ksgat/combat-robot/README.md

# combat-robot
---
title: Hitsink

author: @masoa/mas0a & @gabe/ksgat

description: We are building a fully custom antweight combat robot

created_at: "2025-05-01"
---
Demo vid: 

https://youtube.com/shorts/dfMprFvynx0



combat coming soon trust

bored side quest for two stem scholars

Why?  Ksgat and I belong to an frc team but don't get enough hands on with all aspects of the robot.  We decided to take matters into our own hands and design, build, and compete our own robot.  We went with antweight combat robotics because it has a lower barrier to entry and is an easy beginner competition.  So far, around 8 hours have been put into CAD, and we project assembly to take 10 hours.

BOM

LiperiAir 850 Mah 3s lipo	2	29.98

Bambu tpu for ams black	1	38.99

bambu petg red	1	19.99

rs 2205 2300kv motor	1	12.96

hobbywing skywalker 20amp	1	9.9

30A ESC Brushed Electronic Speed 
Controller	2	19.98

5PCS Mini N20 Gear Motor DC 3V-6V	1	8.99

uxcell M5 x 50mm 12.9 Alloy Steel Hex Socket Head Cap Screw Bolt Black 20pcs	1	9.99

100PCS M5 Locknuts Metric Nylon Inserted Hex Lock Nuts	1	5.99

Tamiya Mini Power Switch (2pk)	1	2.45

Pocket Radio Controller (M2)	1	64.99

Radiomaster ER4 reciever	1	14.99

Sales tax/shipping	$40
[ASSEMBLY GUIDE](https://github.com/ksgat/combat-robot/blob/main/build%20guide/Combat%20Bot%20Assembly.pdf)
