ksgat/combat-robot/V2/Main.stl

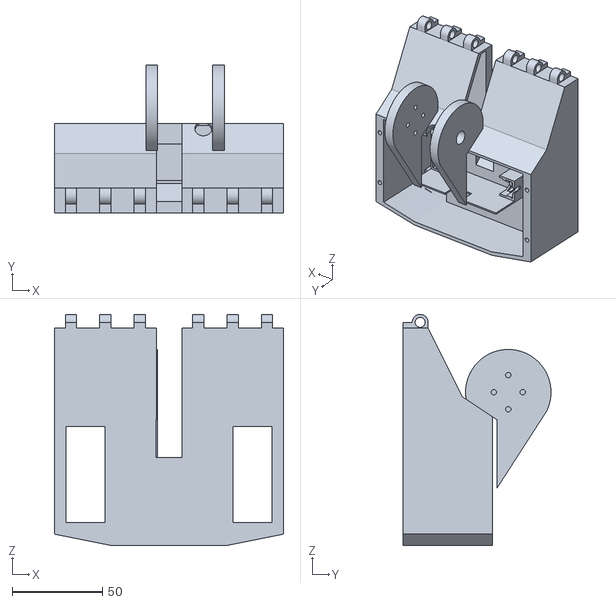
[picture p1: CAD file, 2025-05-15]
V2/Main.stl
127.0 x 82.1 x 128.3
