ksgat/combat-robot/wheel/Vheel.stl

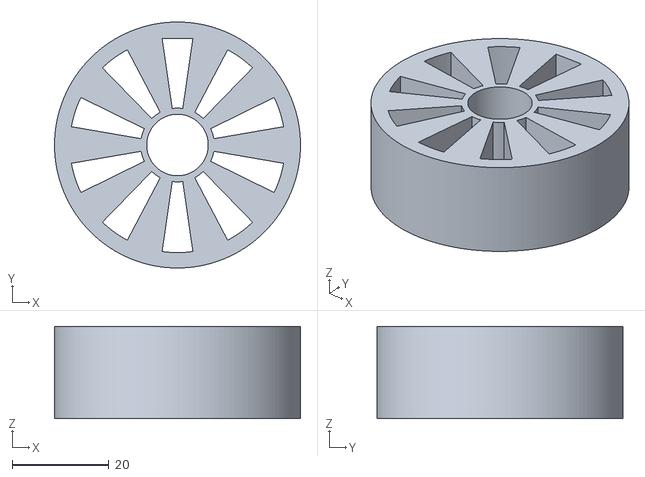
[picture p2: CAD file, 2025-05-22]
wheel/Vheel.stl
50.8 x 50.8 x 19.1
