ksgat/combat-robot/V2/Absorber.stl

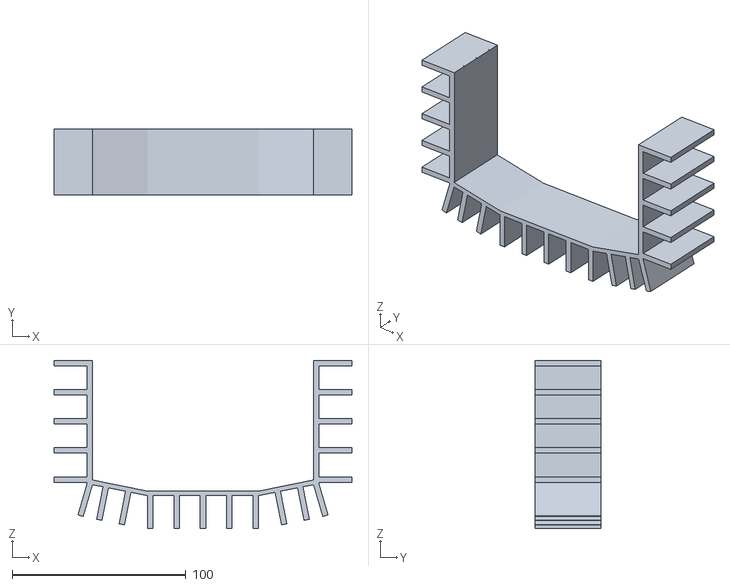
[picture p3: CAD file, 2025-05-15]
V2/Absorber.stl
171.5 x 38.1 x 96.9
