ksgat/combat-robot/wheel/Wheel Hub.stl

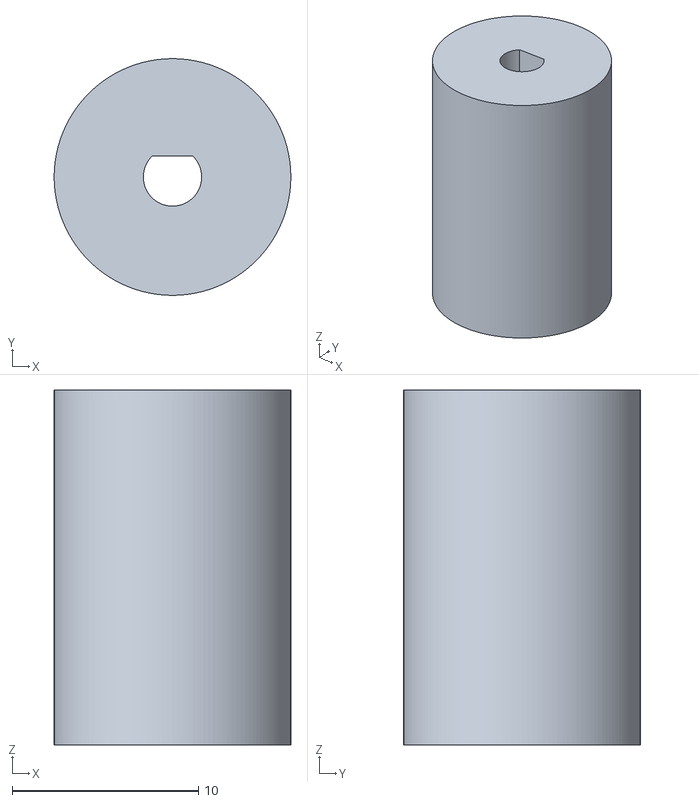
[picture p4: CAD file, 2025-05-22]
wheel/Wheel Hub.stl
12.7 x 12.7 x 19.1
