ksgat/combat-robot/V2/Wedge.stl

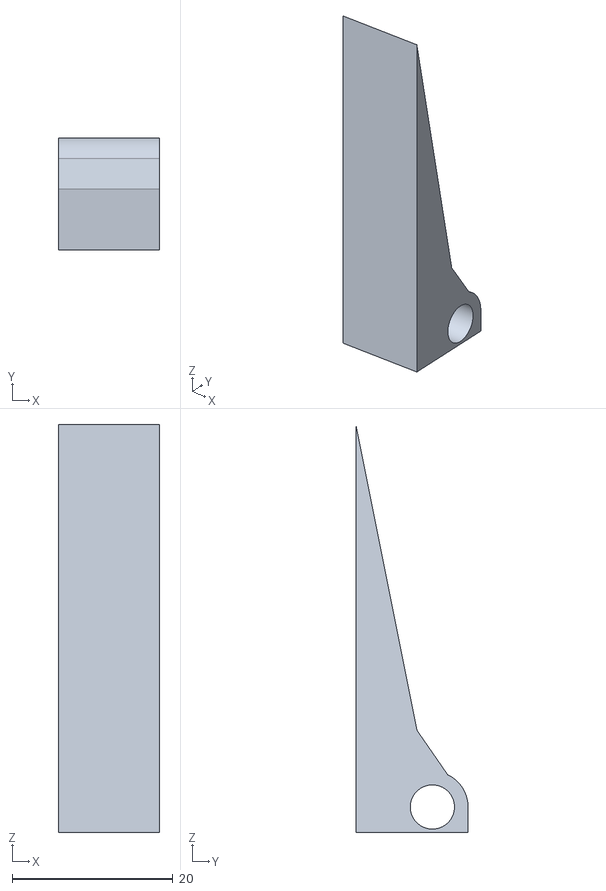
[picture p5: CAD file, 2025-05-15]
V2/Wedge.stl
12.6 x 14.0 x 50.8
