ksgat/combat-robot/V2/Divider.stl

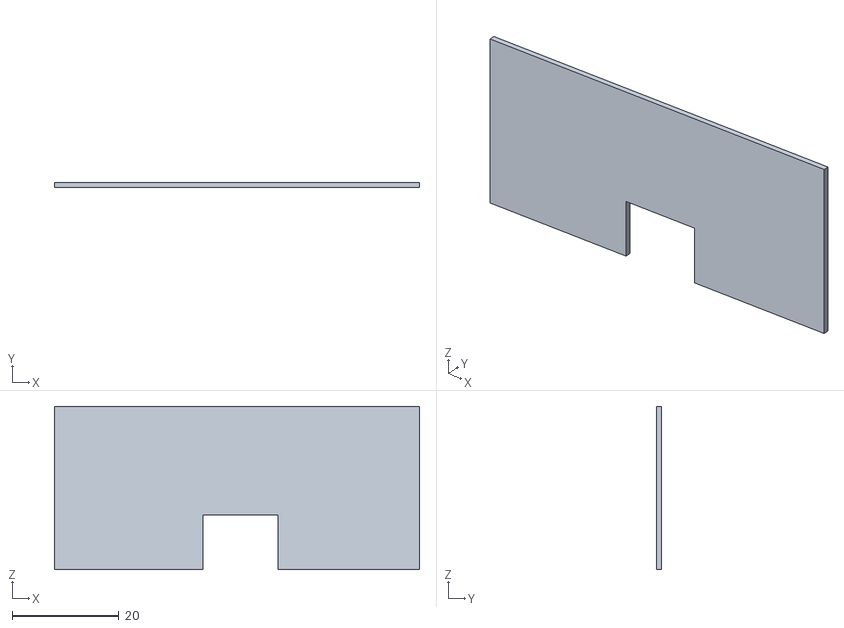
[picture p6: CAD file, 2025-05-15]
V2/Divider.stl
68.2 x 1.00 x 30.5
