ksgat/combat-robot/V2/Lid.stl

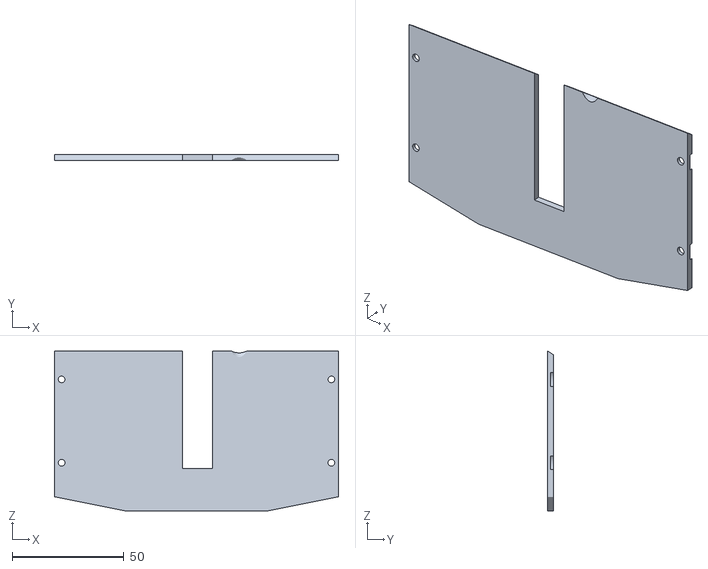
[picture p7: CAD file, 2025-05-15]
V2/Lid.stl
127.0 x 2.54 x 71.5
