ksgat/combat-robot/V2/Blade.stl

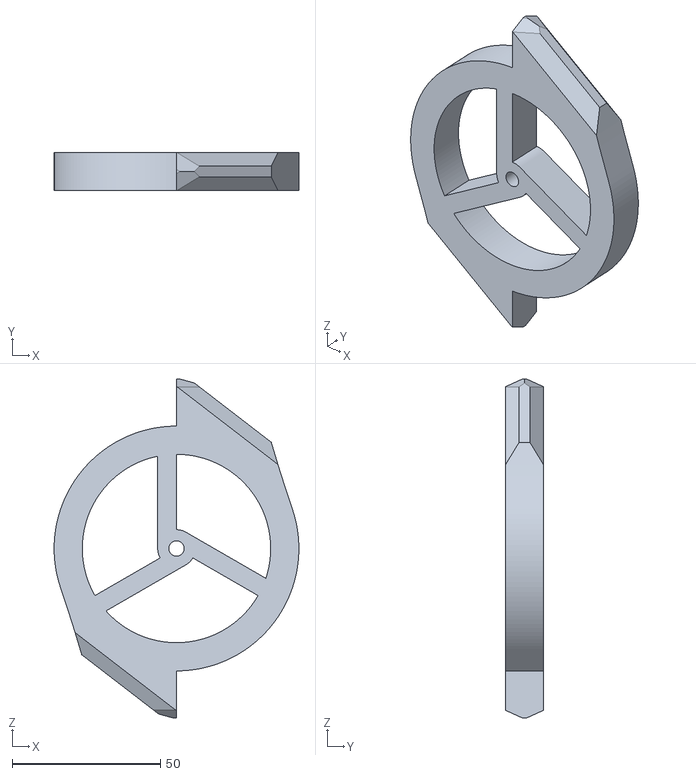
[picture p8: CAD file, 2025-05-15]
V2/Blade.stl
82.5 x 12.7 x 114.3
