ksgat/combat-robot/V1/V1bottomchasis.stl

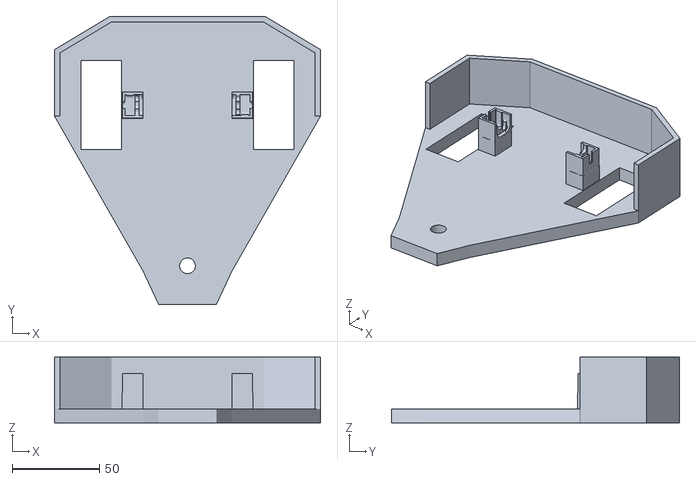
[picture p9: CAD file, 2025-05-15, an earlier design]
V1/V1bottomchasis.stl
152.4 x 165.1 x 37.8
