ksgat/combat-robot/V1/Flywheel.stl

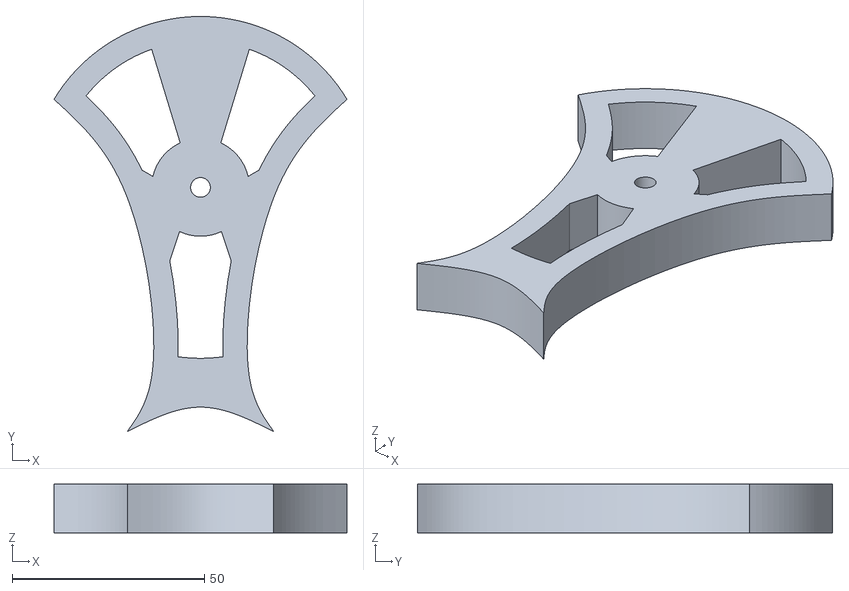
[picture p10: CAD file, 2025-05-15, an earlier design]
V1/Flywheel.stl
76.2 x 108.0 x 12.7
