ksgat/combat-robot/V1/Lid.stl

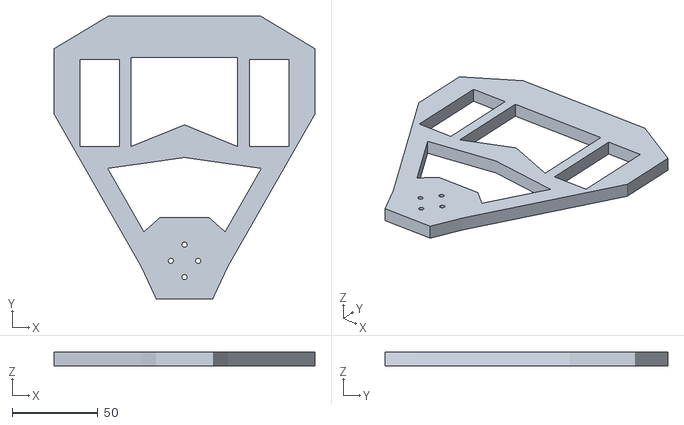
[picture p11: CAD file, 2025-05-15, an earlier design]
V1/Lid.stl
152.4 x 165.1 x 7.94
