ksgat/combat-robot/build guide/Combat Bot Assembly.pdf

1. Print all parts
2. Glue wheel hubs into tires

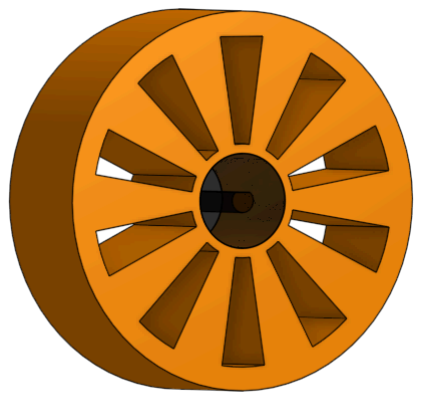
[picture p12: figure]

3. Put n20 motors with wheel, and epoxy to chassis

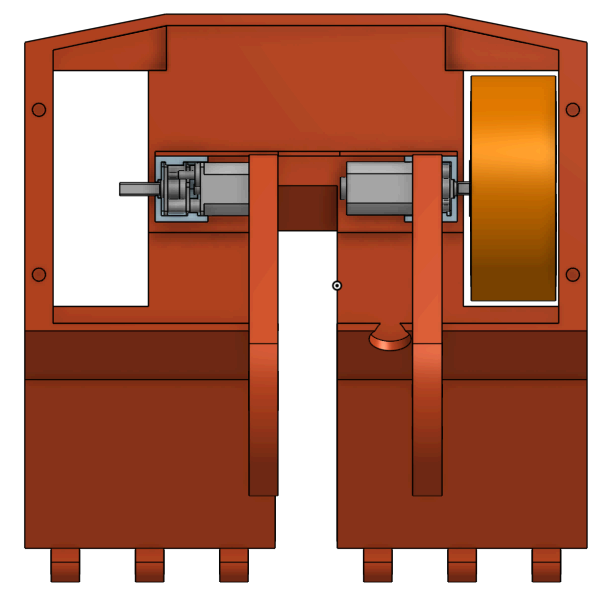
[picture p13: figure]

4. Put blade onto motor and bolt into chassis, put nut onto motor to lock blade on

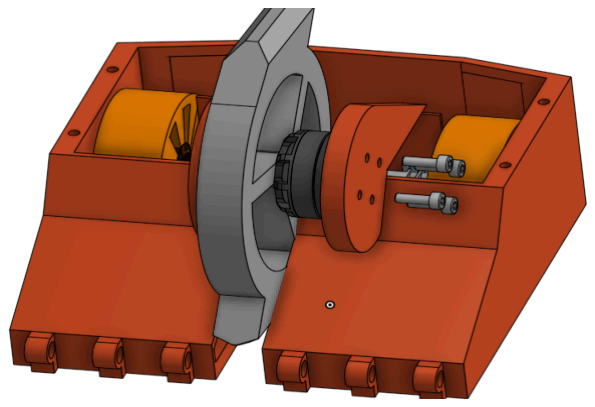
[picture p14: figure]

5. Attach the flipper claws with the m5 nuts and bolts

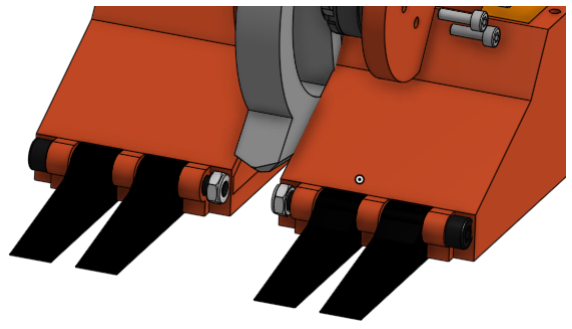
[picture p15: figure]

6. Epoxy the tpu dampener onto the chassis

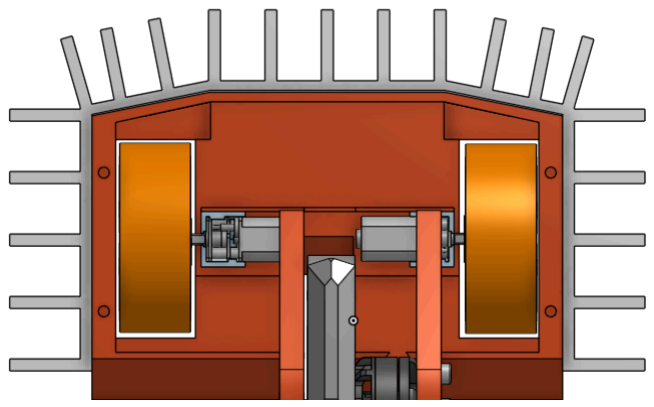
[picture p16: figure]

7. Add battery and electronics according to wiring diagram

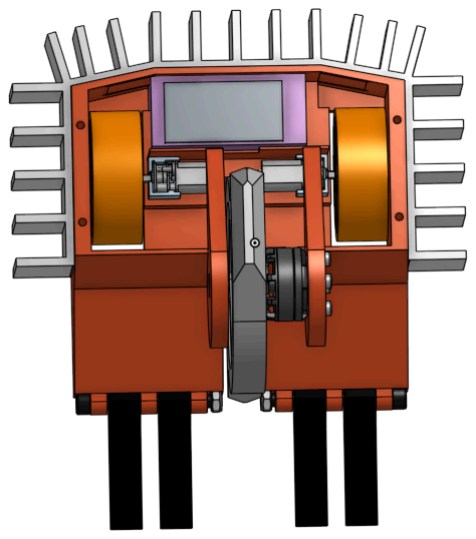
[picture p17: figure]

8. Wiring
a. Make sure to pluck out the power lead on the brushed motor escs so that the receiver doesn't break (only one 5v input needed iirc)

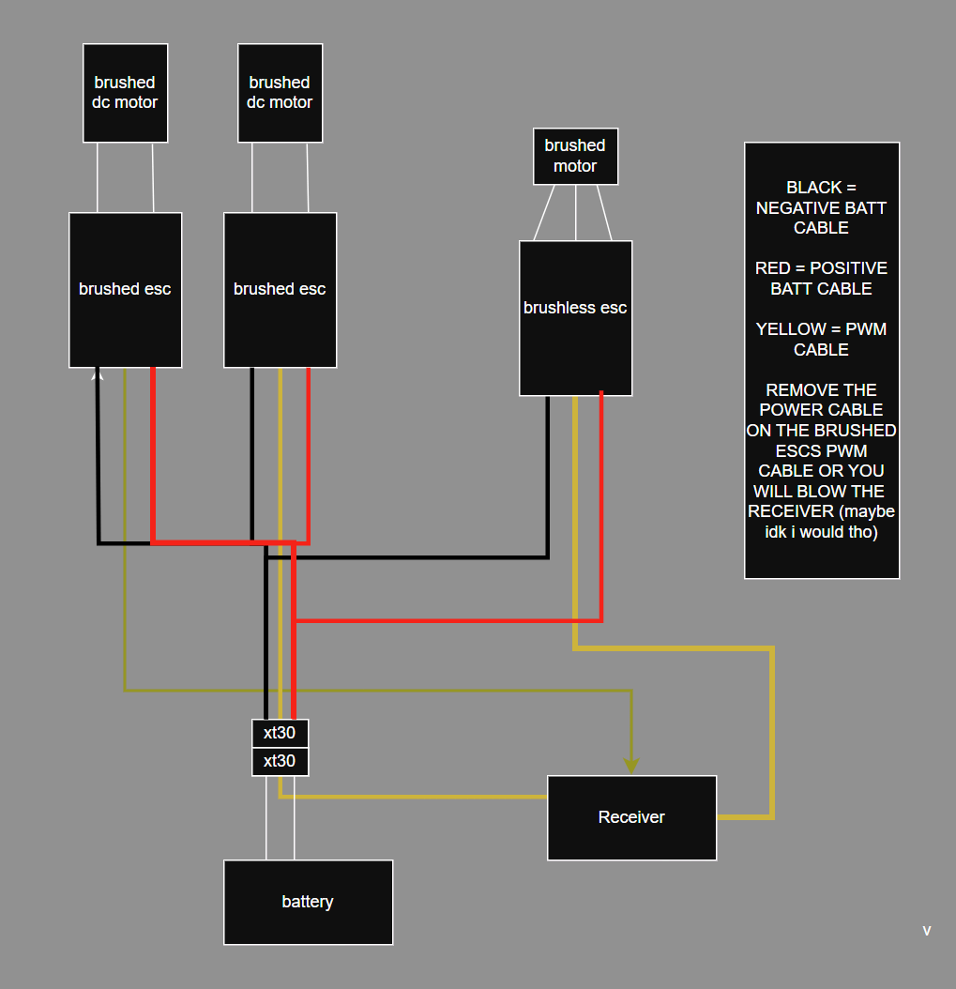
[picture p18: figure]

9. Screw top on and add power switch

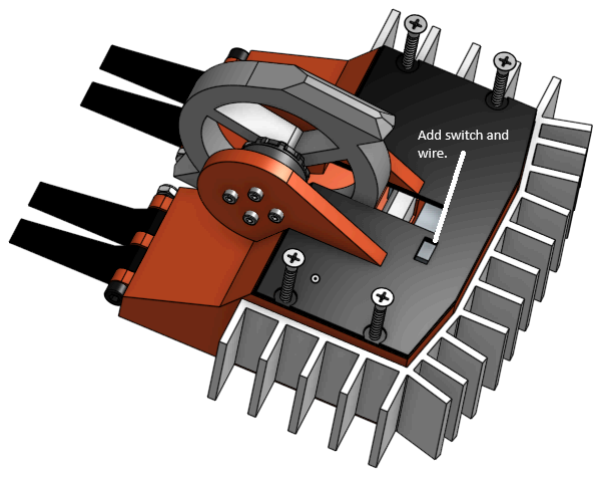
[picture p19: figure]
