ksgat/combat-robot/(commit log)

2025-05-15 Cad file upload
    Cad files
    [Absorber.stl, Blade.stl, Divider.stl, Lid.stl, Main.stl, Vheel.stl, Wedge.stl, Wheel Hub.stl]
2025-05-15 restructure and also upload v1 files
    [Absorber.stl, Blade.stl, Divider.stl, Flywheel.stl, Lid.stl, Main.stl, V1bottomchasis.stl, Wedge.stl]
2025-05-22 Create Wheels
2025-05-22 added project metadata + reorganized cause mason sucks at git
    [Vheel.stl, Wheel Hub.stl]
2025-05-22 Create Materials
2025-05-23 wiring diagram
2025-05-23 Rename Screenshot 2025-05-23 112158.png to wiring.png
2025-05-23 bom added
    [combat robot bom - Sheet1.csv]
2025-05-23 Update and rename combat robot bom - Sheet1.csv to BOM.csv
    [BOM.csv]
